maher3110-pixel/JacoRobotAttachmentInterface/CAD/STL/Research & Development/Gripper/AM 0058 0005 - Hand shell assembly_simple.stl

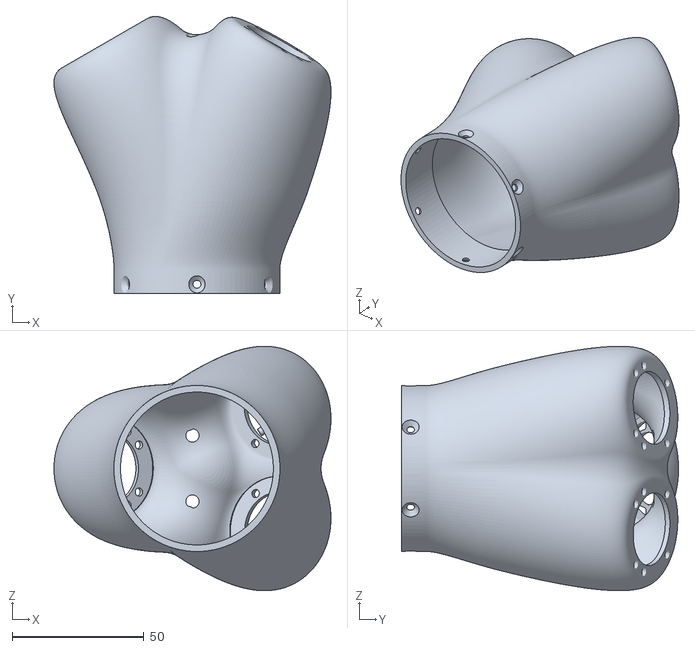
[picture p9: CAD file, 2026-11-12]
CAD/STL/Research & Development/Gripper/AM 0058 0005 - Hand shell assembly_simple.stl
105.1 x 105.2 x 92.8
