maher3110-pixel/JacoRobotAttachmentInterface/CAD/STL/Research & Development/Gripper/AM 3240 0004 - Plastic Finger Assembly Mico - 32mm - 2 Phalanges_simple_Défaut.stl

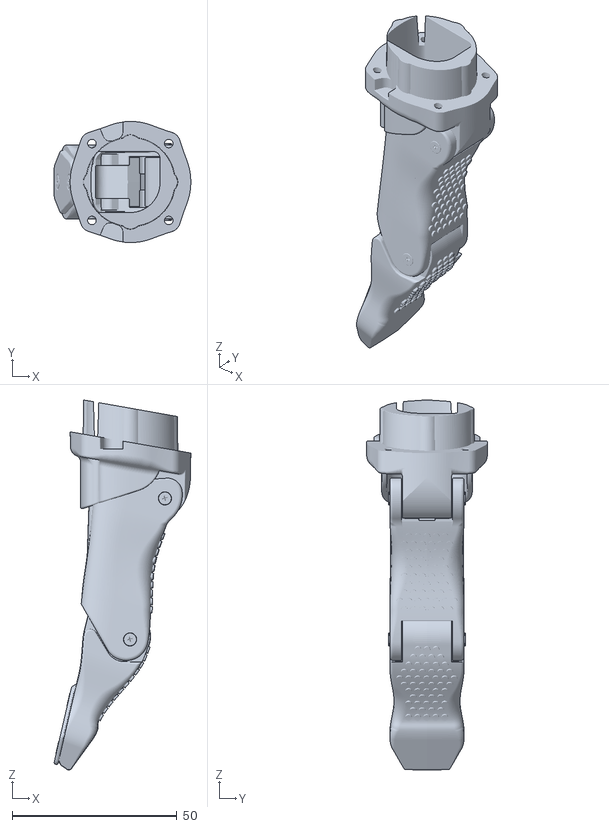
[picture p10: CAD file, 2026-11-12]
CAD/STL/Research & Development/Gripper/AM 3240 0004 - Plastic Finger Assembly Mico - 32mm - 2 Phalanges_simple_Défaut.stl
41.5 x 36.8 x 112.3
