maher3110-pixel/JacoRobotAttachmentInterface/CAD/STEP/Official Study Interfaces/Insert & Twist Interface.step

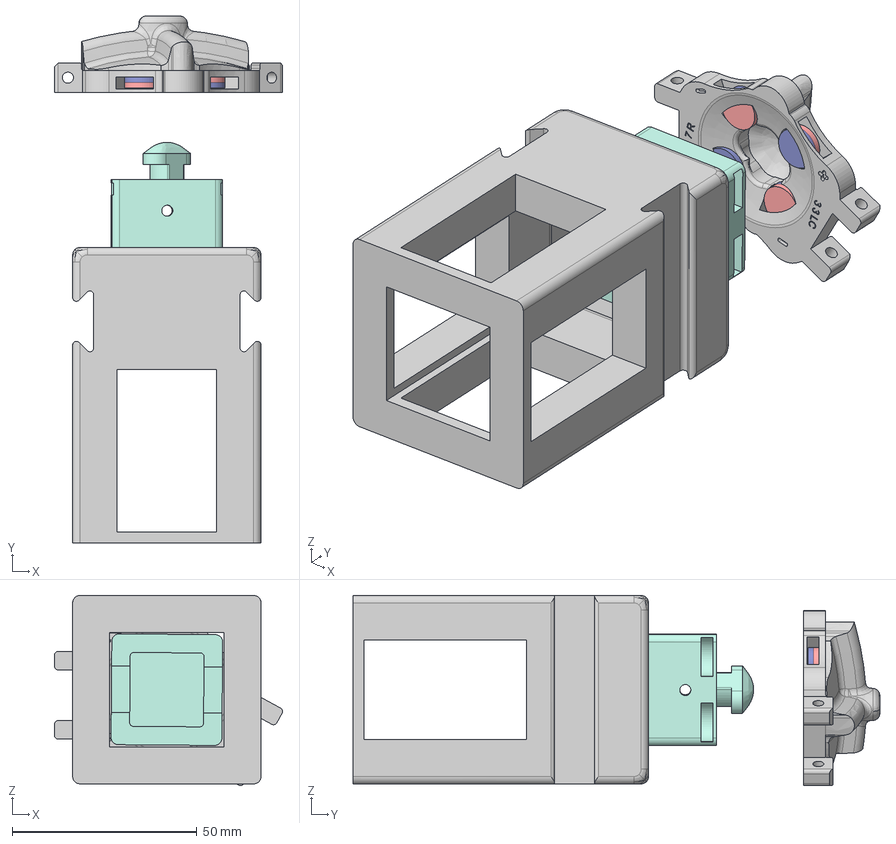
[picture p11: CAD file, 2026-11-12]
CAD/STEP/Official Study Interfaces/Insert & Twist Interface.step
61.8 x 142.7 x 51.5 mm
