maher3110-pixel/JacoRobotAttachmentInterface/CAD/STEP/Official Study Interfaces/Snap On Interface.step

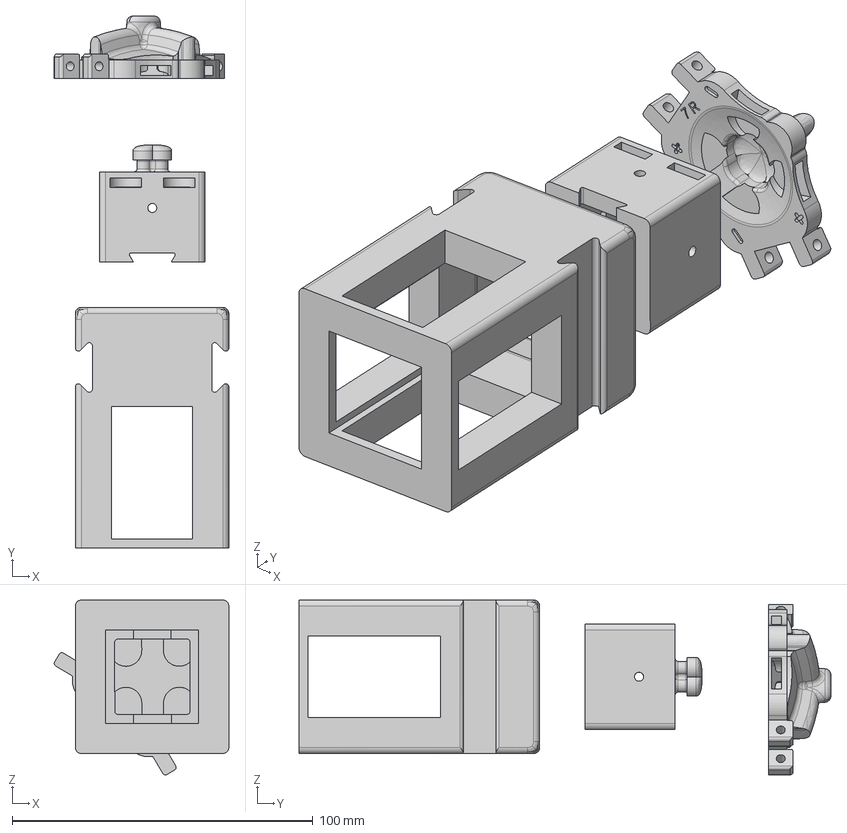
[picture p12: CAD file, 2026-11-12]
CAD/STEP/Official Study Interfaces/Snap On Interface.step
58.0 x 176.8 x 58.1 mm
