maher3110-pixel/JacoRobotAttachmentInterface/CAD/STL/Research & Development/Gripper/MI 1502 0001 - 1.0.0.0002_simple_Nail_shell.stl

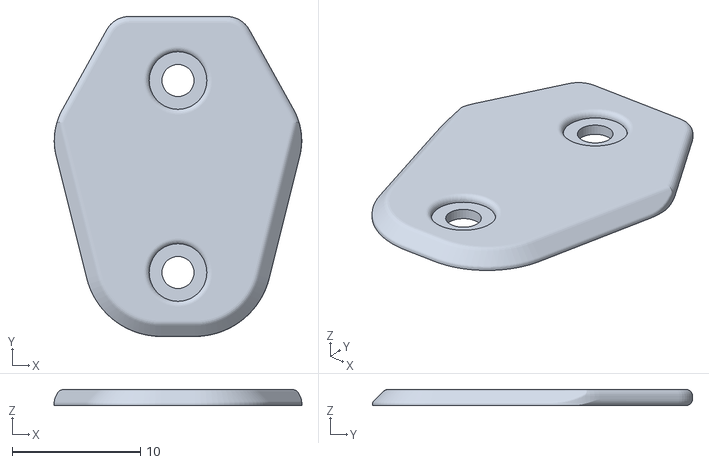
[picture p13: CAD file, 2026-11-12]
CAD/STL/Research & Development/Gripper/MI 1502 0001 - 1.0.0.0002_simple_Nail_shell.stl
19.3 x 25.0 x 1.25
