maher3110-pixel/JacoRobotAttachmentInterface/CAD/STL/Research & Development/Gripper/MI 0000 0002 - 1.0.0.0005_simple_molded_finger_p2.stl

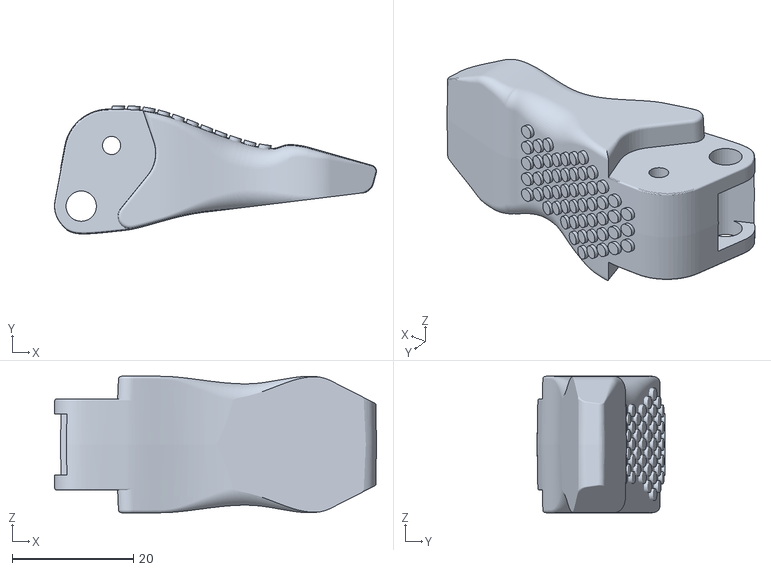
[picture p14: CAD file, 2026-11-12]
CAD/STL/Research & Development/Gripper/MI 0000 0002 - 1.0.0.0005_simple_molded_finger_p2.stl
53.1 x 21.1 x 22.5
