maher3110-pixel/JacoRobotAttachmentInterface/CAD/STL/Research & Development/Gripper/AM 3540 0001 - Linear Actuator - 35mm - 40N.stl

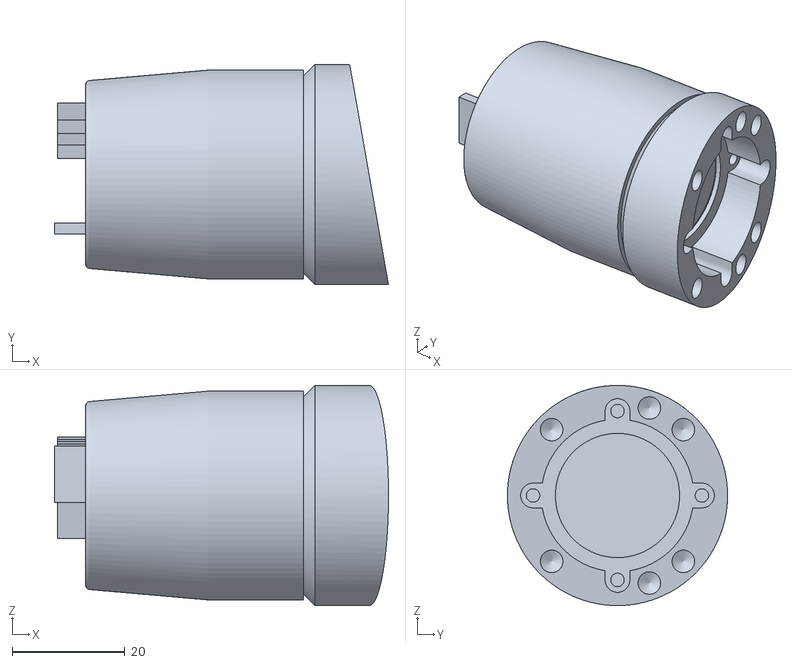
[picture p15: CAD file, 2026-11-12]
CAD/STL/Research & Development/Gripper/AM 3540 0001 - Linear Actuator - 35mm - 40N.stl
59.2 x 39.0 x 39.0
