maher3110-pixel/JacoRobotAttachmentInterface/(list of files, cad)

Other CAD files:
CAD/Fusion360/Official Study Interfaces/Insert & Twist Interface.f3d
CAD/Fusion360/Official Study Interfaces/Snap On Interface.f3d
CAD/Fusion360/Research & Development/Gripper/AM 0058 0005 - Hand shell assembly_simple.f3d
CAD/Fusion360/Research & Development/Gripper/KG-3 without fingers.f3d
CAD/Fusion360/Research & Development/Gripper/KG-3.f3d
CAD/Fusion360/Research & Development/Gripper/Rubber palm original mold.f3d
CAD/Fusion360/Research & Development/Holster Designs/Tool Slot Holster Final.f3d
CAD/Fusion360/Research & Development/Holster Designs/Tool Slot Holster V0.f3d
CAD/Fusion360/Research & Development/Holster Designs/Tool Slot Holster V2.f3d
CAD/Fusion360/Research & Development/Holster Designs/Tool Slot Holster V3.f3d
CAD/Fusion360/Research & Development/Holster Designs/Tool Slot Holster V4.f3d
CAD/Fusion360/Research & Development/Holster Designs/Tool Slot Holster V5.f3d
CAD/Fusion360/Research & Development/Holster Designs/Tool Slot Holster V6.f3d
CAD/Fusion360/Research & Development/Last Year Assets/New Version with socket.f3d
CAD/Fusion360/Research & Development/Last Year Assets/Pen Attachment 0.1.f3d
CAD/Fusion360/Research & Development/Last Year Assets/Pen Attachment 2.0.f3d
CAD/Fusion360/Research & Development/Last Year Assets/Pen Attachment double.f3d
CAD/Fusion360/Research & Development/Last Year Assets/Pen Attachment inbuilt flex 2.0.f3d
CAD/Fusion360/Research & Development/Last Year Assets/Strap.f3d
CAD/Fusion360/Research & Development/Last Year Assets/Tonges Attachment.f3d
CAD/Fusion360/Research & Development/Last Year Assets/X negative with socket 45 and strap 2.2.f3d
CAD/Fusion360/Research & Development/Last Year Assets/X negative with socket 45 and strap 2.3.f3d
CAD/Fusion360/Research & Development/Online Attachment Models/Kelvin_and_Maxwell_top.f3d
CAD/Fusion360/Research & Development/Online Attachment Models/Kelvin_bottom.f3d
CAD/Fusion360/Research & Development/Online Attachment Models/Kinematic_Coupler.f3d
CAD/Fusion360/Research & Development/Online Attachment Models/Maxwell_bottom.f3d
CAD/Fusion360/Research & Development/Online Attachment Models/kinematic-1.f3d
CAD/Fusion360/Research & Development/Online Attachment Models/kinematic-2.f3d
CAD/Fusion360/Research & Development/Online Attachment Models/kinematic_Coupler_Ball.f3d
CAD/Fusion360/Research & Development/Online Attachment Models/kinematic_Coupler_Vgrove.f3d
CAD/Fusion360/Research & Development/Palm Designs/Insert & Twist Modes Limit - Square Pattern.f3d
CAD/Fusion360/Research & Development/Palm Designs/Inster & Twist, No magnets V0.f3d
CAD/Fusion360/Research & Development/Palm Designs/Palm Positive Modified w plain face.f3d
CAD/Fusion360/Research & Development/Palm Designs/Palm Positive Unmodified.f3d
CAD/Fusion360/Research & Development/Tool Designs/Palm No Lock - V Unused.f3d
CAD/Fusion360/Research & Development/Tool Designs/Tool Attachment V1 Test.f3d
CAD/Fusion360/Research & Development/Tool Designs/Tool Attachment V1.f3d
CAD/Fusion360/Research & Development/Tool Designs/Tool Attachment V2.f3d
CAD/Fusion360/Research & Development/Tool Designs/Tool Attachment V3.f3d
CAD/Fusion360/Research & Development/Tool Designs/Tool Attachment V4 No lock.f3d
CAD/Fusion360/Research & Development/Tool Designs/Tool Attachment V4.f3d
CAD/Fusion360/Research & Development/Tool Designs/Tool Attachment V6 Test.f3d
CAD/Fusion360/Research & Development/Tool Designs/Tool Attachment VFail.f3d
