maher3110-pixel/JacoRobotAttachmentInterface/(commit log)

2026-11-11 Create CAD project folder structure
2026-11-12 Add CAD project organisation structure
2026-11-12 Add Fusion CAD exports for study and research
    [AM 0058 0005 - Hand shell assembly_simple.f3d, AM 0058 0005 - Hand shell assembly_simple.stl, AM 3240 0004 - Plastic Finger Assembly Mico - 32mm - 2 Phalanges_simple_Défaut.stl, AM 3540 0001 - Linear Actuator - 35mm - 40N.stl, Insert & Twist Interface.f3d, Insert & Twist Interface.step, Insert & Twist Modes Limit - Square Pattern.f3d, Inster & Twist, No magnets V0.f3d]
2026-11-12 Organize CAD exports by file format
    [AM 0058 0005 - Hand shell assembly_simple.f3d, AM 0058 0005 - Hand shell assembly_simple.stl, AM 3240 0004 - Plastic Finger Assembly Mico - 32mm - 2 Phalanges_simple_Défaut.stl, AM 3540 0001 - Linear Actuator - 35mm - 40N.stl, Insert & Twist Interface.f3d, Insert & Twist Interface.step, Insert & Twist Modes Limit - Square Pattern.f3d, Inster & Twist, No magnets V0.f3d]
2026-11-12 Consolidate CAD documentation
